XAffanX/multi-rail-linear-power-supply/hardware/LinearPowerSupply.kicad_pcb

## KiCad design hardware/LinearPowerSupply.kicad_pcb (2026-11-02)

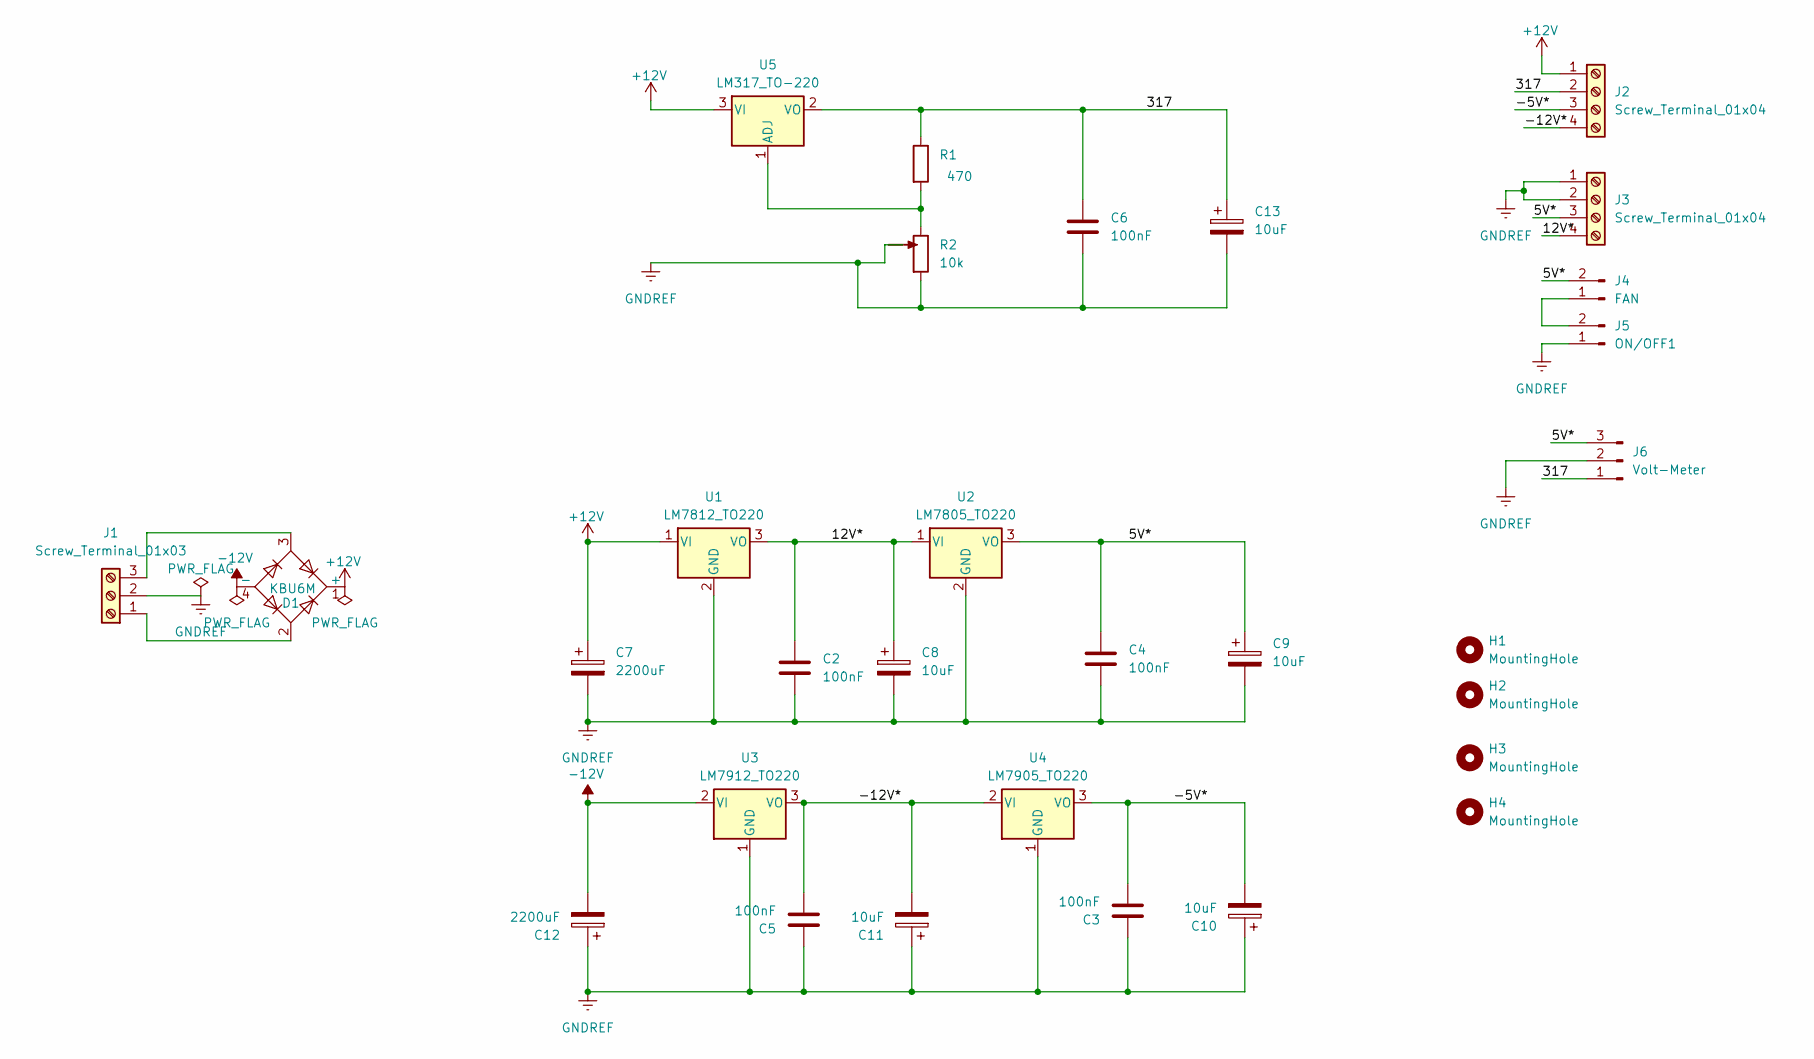
[picture p4: schematic LinearPowerSupply.kicad_sch, PowerSupply Version One]

Parts:
C2, C3, C4, C5, C6: 100nF; C_Disc_D5.0mm_W2.5mm_P5.00mm
C7, C12: 2200uF; CP_Radial_D12.5mm_P5.00mm
C8, C9, C10, C11, C13: 10uF; CP_Radial_D5.0mm_P2.00mm
D1: KBU6M; Diode_Bridge_Vishay_KBU
H1, H2, H3, H4: MountingHole; MountingHole_3.2mm_M3
J1: Screw_Terminal_01x03; TerminalBlock_Phoenix_MKDS-1,5-3-5.08_1x03_P5.08mm_Horizont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
J2, J3: Screw_Terminal_01x04; TerminalBlock_Phoenix_MKDS-1,5-4-5.08_1x04_P5.08mm_Horizont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
J4: FAN; PinHeader_1x02_P2.54mm_Vertical
J5: ON/OFF1; TerminalBlock_Phoenix_MKDS-1,5-2-5.08_1x02_P5.08mm_Horizont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
J6: Volt-Meter; PinHeader_1x03_P2.54mm_Vertical
R1: 470; R_Axial_DIN0207_L6.3mm_D2.5mm_P10.16mm_Horizontal
R2: 10k; Potentiometer_Bourns_3296W_Vertical
U1: LM7812_TO220; TO-220-3_Vertical
U2: LM7805_TO220; TO-220-3_Vertical
U3: LM7912_TO220; TO-220-3_Vertical
U4: LM7905_TO220; TO-220-3_Vertical
U5: LM317_TO-220; TO-220-3_Vertical

Connections:
+12V: C7.1, D1.1 (+), J2.1, U1.1 (VI), U5.3 (VI)
-12V: C12.2, D1.4 (-), U3.2 (VI)
/5V*: C4.1, C9.1, J3.3, J4.2, J6.3, U2.3 (VO)
/12V*: C2.1, C8.1, J3.4, U1.3 (VO), U2.1 (VI)
/317: C6.1, C13.1, J2.2, J6.1, R1.1, U5.2 (VO)
/-5V*: C3.2, C10.2, J2.3, U4.3 (VO)
/-12V*: C5.2, C11.2, J2.4, U3.3 (VO), U4.2 (VI)
GNDREF: C2.2, C3.1, C4.2, C5.1, C6.2, C7.2, C8.2, C9.2, C10.1, C11.1, C12.1, C13.2, J1.2, J3.1, J3.2, J5.1, J6.2, R2.2, U1.2 (GND), U2.2 (GND), U3.1 (GND), U4.1 (GND)
unnamed: D1.2, J1.1
unnamed: D1.3, J1.3
unnamed: J4.1, J5.2
unnamed: R1.2, R2.1, U5.1 (ADJ)

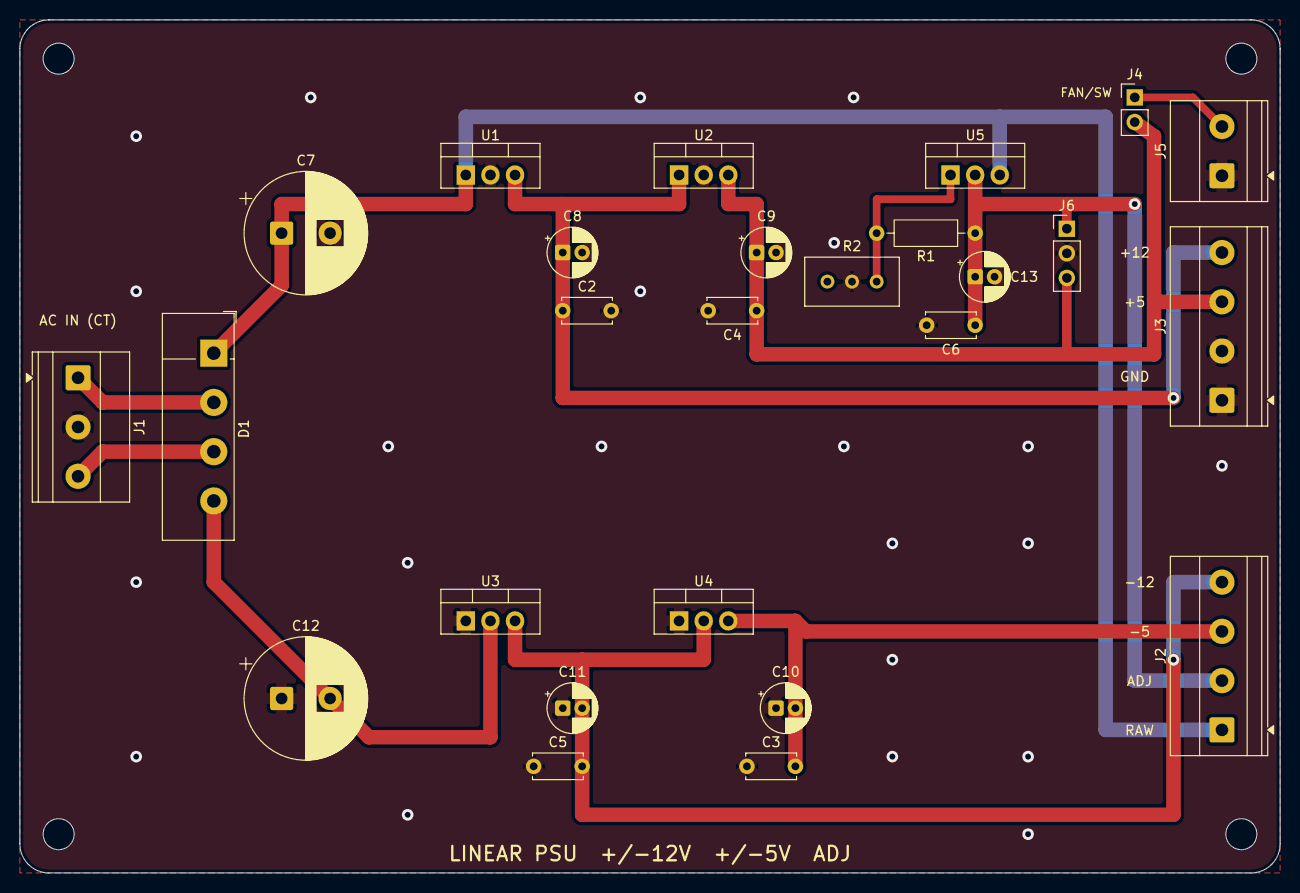
[picture p5: board LinearPowerSupply.kicad_pcb from above]

Board: 2 copper layers, 130.0 x 88.0 mm, 30 parts (0 on the bottom side), 12 nets.
